AlexandroSantos/ProjCpp/(list of files, drawings)

Other design files:
ArControl_Kicad/ArControl.dsn
