AlexandroSantos/ProjCpp/ArControl_Kicad/ArControl.sch

## KiCad design ArControl_Kicad/ArControl.sch (2021-04-22)

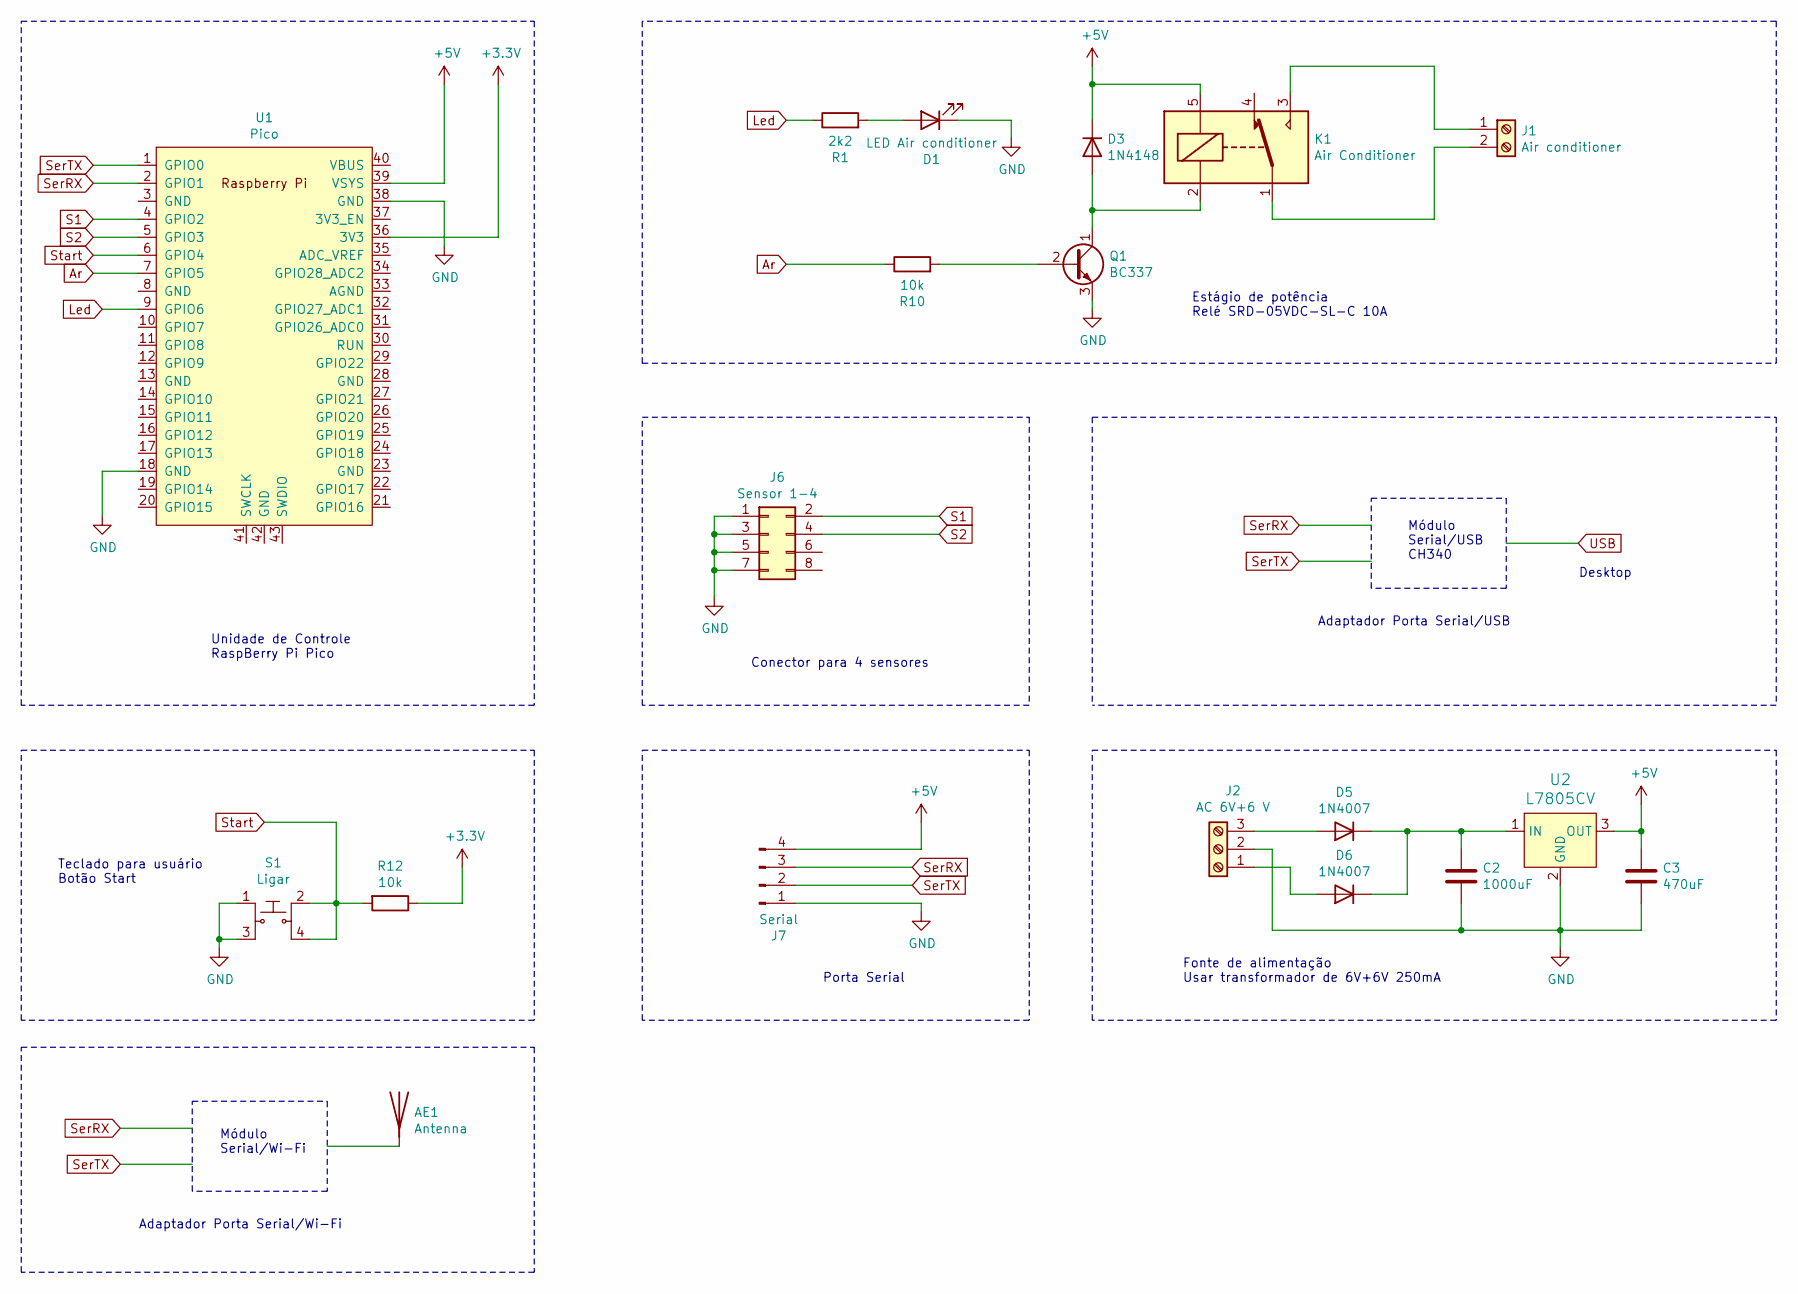
[picture p6: schematic ArControl.sch]

Parts:
AE1: Antenna
C2: 1000uF; CP_Radial_Tantal_D10.5mm_P5.00mm
C3: 470uF; CP_Radial_Tantal_D10.5mm_P5.00mm
D1: LED Air conditioner; LED_D3.0mm
D3: 1N4148; D_DO-35_SOD27_P7.62mm_Horizontal
D5, D6: 1N4007; D_DO-41_SOD81_P10.16mm_Horizontal
J1: Air conditioner; TerminalBlock_RND_205-00001_1x02_P5.00mm_Horizontal
J2: AC 6V+6 V; TerminalBlock_RND_205-00002_1x03_P5.00mm_Horizontal
J6: Sensor 1-4; PinHeader_2x04_P2.54mm_Vertical
J7: Serial; PinHeader_1x04_P2.54mm_Horizontal
K1: Air Conditioner; Relay_SPDT_SANYOU_SRD_Series_Form_C
Q1: BC337; TO-92_Wide
R1: 2k2; R_Axial_DIN0207_L6.3mm_D2.5mm_P10.16mm_Horizontal
R10, R12: 10k; R_Axial_DIN0207_L6.3mm_D2.5mm_P10.16mm_Horizontal
S1: Ligar; SW_PUSH_6mm_H7.3mm; MPN KS-01Q-01; Digi-Key_PN EG4791-ND
U1: Pico; RPi_Pico_SMD_TH
U2: L7805CV; TO-220-3; MPN L7805CV; Digi-Key_PN 497-1443-5-ND

Connections:
+3.3V: R12.1, U1.36 (3V3)
+5V: C3.1, D3.1 (K), J7.4, K1.5, U1.39 (VSYS), U2.3 (OUT)
Ar: R10.1, U1.7 (GPIO5)
GND: C2.2, C3.2, D1.1 (K), J2.2, J6.1, J6.3, J6.5, J6.7, J7.1, Q1.3 (E), S1.1, S1.3, U1.18 (GND), U1.38 (GND), U2.2 (GND)
Led: R1.1, U1.9 (GPIO6)
unnamed: C2.1, D5.1 (K), D6.1 (K), U2.1 (IN)
unnamed: D1.2 (A), R1.2
unnamed: D3.2 (A), K1.2, Q1.1 (C)
unnamed: D5.2 (A), J2.3
unnamed: D6.2 (A), J2.1
unnamed: J1.1, K1.3
unnamed: J1.2, K1.1
unnamed: Q1.2 (B), R10.2
S1: J6.2, U1.4 (GPIO2)
S2: J6.4, U1.5 (GPIO3)
SerRX: J7.3, U1.2 (GPIO1)
SerTX: J7.2, U1.1 (GPIO0)
Start: R12.2, S1.2, S1.4, U1.6 (GPIO4)

Notes on the sheet:
Estágio de potência Relé SRD-05VDC-SL-C 10A
Fonte de alimentação Usar transformador de 6V+6V 250mA
Conector para 4 sensores
Teclado para usuário Botão Start
Unidade de Controle RaspBerry Pi Pico
Módulo Serial/USB CH340
Desktop
Porta Serial
Adaptador Porta Serial/USB
Módulo Serial/Wi-Fi
Adaptador Porta Serial/Wi-Fi
